viviansuzano/master-board/hardware/V3/master_board_labrob.brd

## EAGLE design hardware/V3/master_board_labrob.brd (2022-05-29)

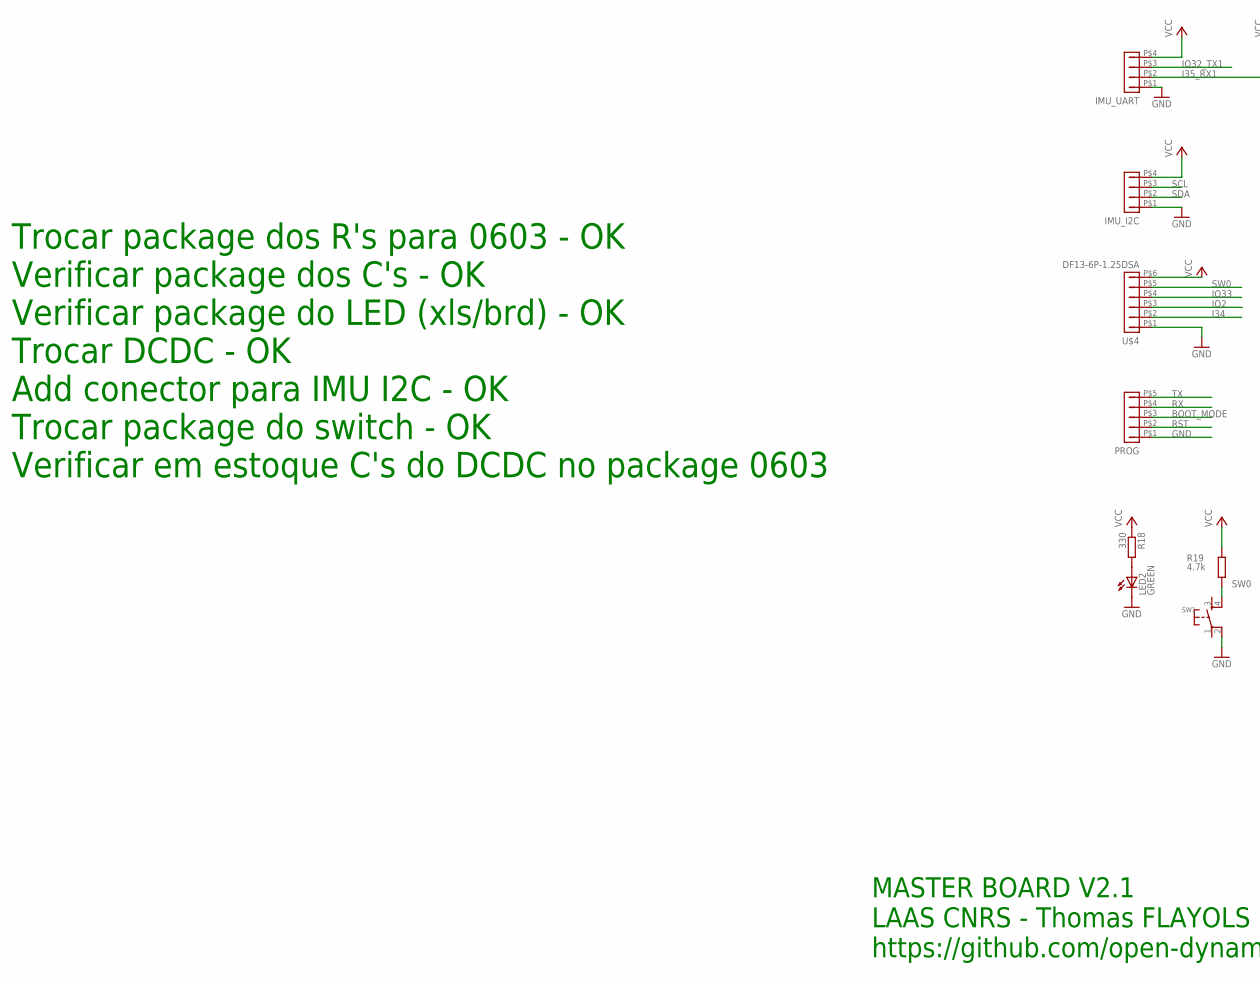
[picture p1: schematic master_board_labrob.sch, part in row 1, column 1]

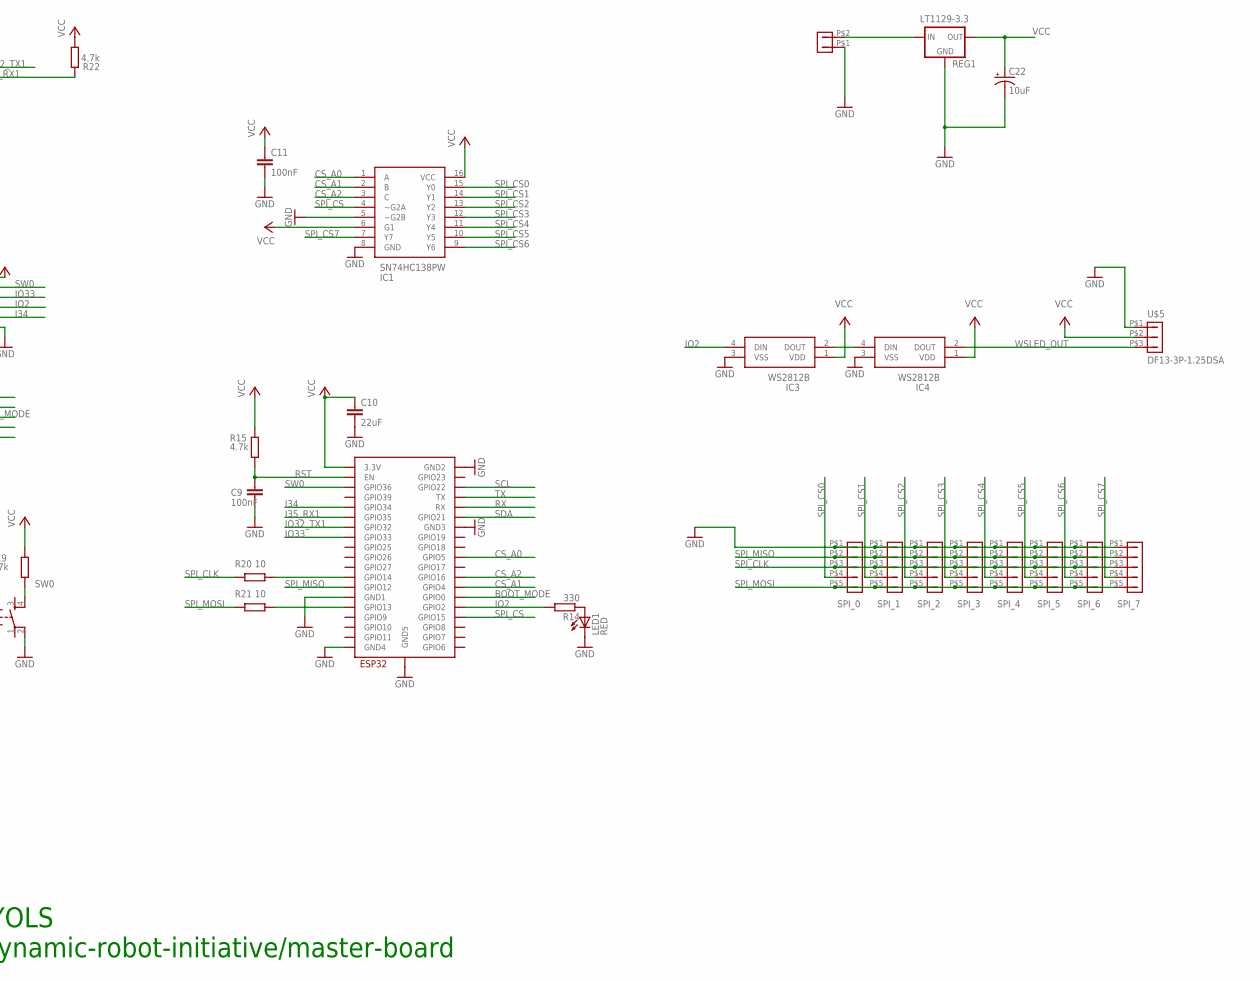
[picture p2: schematic master_board_labrob.sch, part in row 1, column 2]

Parts:
C9, C11: 100nF; C0603; MANUFACTURER_PART_NUMBER CPL-CAP-X7R-0402-100NF-16V
C10: 22uF; C0805; MANUFACTURER_PART_NUMBER CPL-CAP-X5R-0805-22UF-6.3V
C22: 10uF; C/6032-28R
IC1: SN74HC138PW; SOP65P640X120-16N
IC3, IC4: WS2812B
IMU_I2C: DF13-4P-1.25DSA; MANUFACTURER_PART_NUMBER DF13-4P-1.25DSA
IMU_UART: DF13-4P-1.25DSA; MANUFACTURER_PART_NUMBER DF13-4P-1.25DSA
LED1: RED; CHIPLED_0603; MANUFACTURER_PART_NUMBER CPL-LED-0603-RED
LED2: GREEN; CHIPLED_0603; MANUFACTURER_PART_NUMBER CPL-LED-0603-GREEN
POWER: DF13-2P-1.25DSA; MANUFACTURER_PART_NUMBER DF13-3P-1.25DSA
PROG: DF13-5P-1.25DSA; MANUFACTURER_PART_NUMBER DF13-5P-1.25DSA
R14, R18: 330; R0603; MANUFACTURER_PART_NUMBER RC0402JR-13330RL
R15, R19, R22: 4.7k; R0603; MANUFACTURER_PART_NUMBER CPL-RES-0402-4.7K-0.063W
R20, R21: 10; R0603; MANUFACTURER_PART_NUMBER CPL-RES-0402-10-0.063W
REG1: LT1129-3.3; SOT223
SPI_0, SPI_1, SPI_2, SPI_3, SPI_4, SPI_5, SPI_6, SPI_7: DF13-5P-1.25DSA; MANUFACTURER_PART_NUMBER DF13-5P-1.25DSA
SW1: B3U-1000P-2P-SMD; DTSM-6; MANUFACTURER_PART_NUMBER B3U-1000P
U$1: ESP32-WROOM; MANUFACTURER_PART_NUMBER ESP32-WROOM-32D
U$4: DF13-6P-1.25DSA; MANUFACTURER_PART_NUMBER DF13-6P-1.25DSA
U$5: DF13-3P-1.25DSA; MANUFACTURER_PART_NUMBER DF13-3P-1.25DSA

Connections:
BOOT_MODE: PROG.P$3 (3), U$1.IO0 (GPIO0)
CS_A0: IC1.1 (A), U$1.IO5 (GPIO5)
CS_A1: IC1.2 (B), U$1.IO4 (GPIO4)
CS_A2: IC1.3 (C), U$1.IO16 (GPIO16)
GND: C9.2, C10.2, C11.2, C22.-, IC1.5 (~G2B), IC1.8 (GND), IC3.3 (VSS), IC4.3 (VSS), IMU_I2C.P$1 (1), IMU_UART.P$1 (1), LED1.C, LED2.C, POWER.P$1 (1), PROG.P$1 (1), REG1.2 (GND), REG1.TAB (GND), SPI_0.P$1 (1), SPI_1.P$1 (1), SPI_2.P$1 (1), SPI_3.P$1 (1), SPI_4.P$1 (1), SPI_5.P$1 (1), SPI_6.P$1 (1), SPI_7.P$1 (1), SW1.2, U$1.GND1, U$1.GND2, U$1.GND3, U$1.GND4, U$1.GND5, U$4.P$1 (1), U$5.P$1 (1)
I34: U$1.IO34 (GPIO34), U$4.P$2 (2)
I35_RX1: IMU_UART.P$2 (2), R22.2, U$1.IO35 (GPIO35)
IO2: IC3.4 (DIN), R14.2, U$1.IO2 (GPIO2), U$4.P$3 (3)
IO32_TX1: IMU_UART.P$3 (3), U$1.IO32 (GPIO32)
IO33: U$1.IO33 (GPIO33), U$4.P$4 (4)
unnamed: IC3.2 (DOUT), IC4.4 (DIN)
unnamed: POWER.P$2 (2), REG1.1 (IN)
unnamed: LED1.A, R14.1
unnamed: R21.2, U$1.IO13 (GPIO13)
unnamed: LED2.A, R18.2
unnamed: R20.2, U$1.IO14 (GPIO14)
RST: C9.1, PROG.P$2 (2), R15.1, U$1.EN
RX: PROG.P$4 (4), U$1.RX
SCL: IMU_I2C.P$3 (3), U$1.IO22 (GPIO22)
SDA: IMU_I2C.P$2 (2), U$1.IO21 (GPIO21)
SPI_CLK: R20.1, SPI_0.P$3 (3), SPI_1.P$3 (3), SPI_2.P$3 (3), SPI_3.P$3 (3), SPI_4.P$3 (3), SPI_5.P$3 (3), SPI_6.P$3 (3), SPI_7.P$3 (3)
SPI_CS: IC1.4 (~G2A), U$1.IO15 (GPIO15)
SPI_CS0: IC1.15 (Y0), SPI_0.P$4 (4)
SPI_CS1: IC1.14 (Y1), SPI_1.P$4 (4)
SPI_CS2: IC1.13 (Y2), SPI_2.P$4 (4)
SPI_CS3: IC1.12 (Y3), SPI_3.P$4 (4)
SPI_CS4: IC1.11 (Y4), SPI_4.P$4 (4)
SPI_CS5: IC1.10 (Y5), SPI_5.P$4 (4)
SPI_CS6: IC1.9 (Y6), SPI_6.P$4 (4)
SPI_CS7: IC1.7 (Y7), SPI_7.P$4 (4)
SPI_MISO: SPI_0.P$2 (2), SPI_1.P$2 (2), SPI_2.P$2 (2), SPI_3.P$2 (2), SPI_4.P$2 (2), SPI_5.P$2 (2), SPI_6.P$2 (2), SPI_7.P$2 (2), U$1.IO12 (GPIO12)
SPI_MOSI: R21.1, SPI_0.P$5 (5), SPI_1.P$5 (5), SPI_2.P$5 (5), SPI_3.P$5 (5), SPI_4.P$5 (5), SPI_5.P$5 (5), SPI_6.P$5 (5), SPI_7.P$5 (5)
SW0: R19.1, SW1.4, U$1.SENSOR_VP (GPIO36), U$4.P$5 (5)
TX: PROG.P$5 (5), U$1.TX
VCC: C10.1, C11.1, C22.+, IC1.6 (G1), IC1.16 (VCC), IC3.1 (VDD), IC4.1 (VDD), IMU_I2C.P$4 (4), IMU_UART.P$4 (4), R15.2, R18.1, R19.2, R22.1, REG1.3 (OUT), U$1.3V3 (3.3V), U$4.P$6 (6), U$5.P$2 (2)
WSLED_OUT: IC4.2 (DOUT), U$5.P$3 (3)

Notes on the sheet:
MASTER BOARD V2.1 LAAS CNRS - Thomas FLAYOLS https://github.com/open-dynamic-robot-initiative/master-board
Trocar package dos R's para 0603 - OK Verificar package dos C's - OK Verificar package do LED (xls/brd) - OK Trocar DCDC - OK Add conector para IMU I2C - OK Trocar package do switch - OK Verificar em estoque C's do DCDC no package 0603

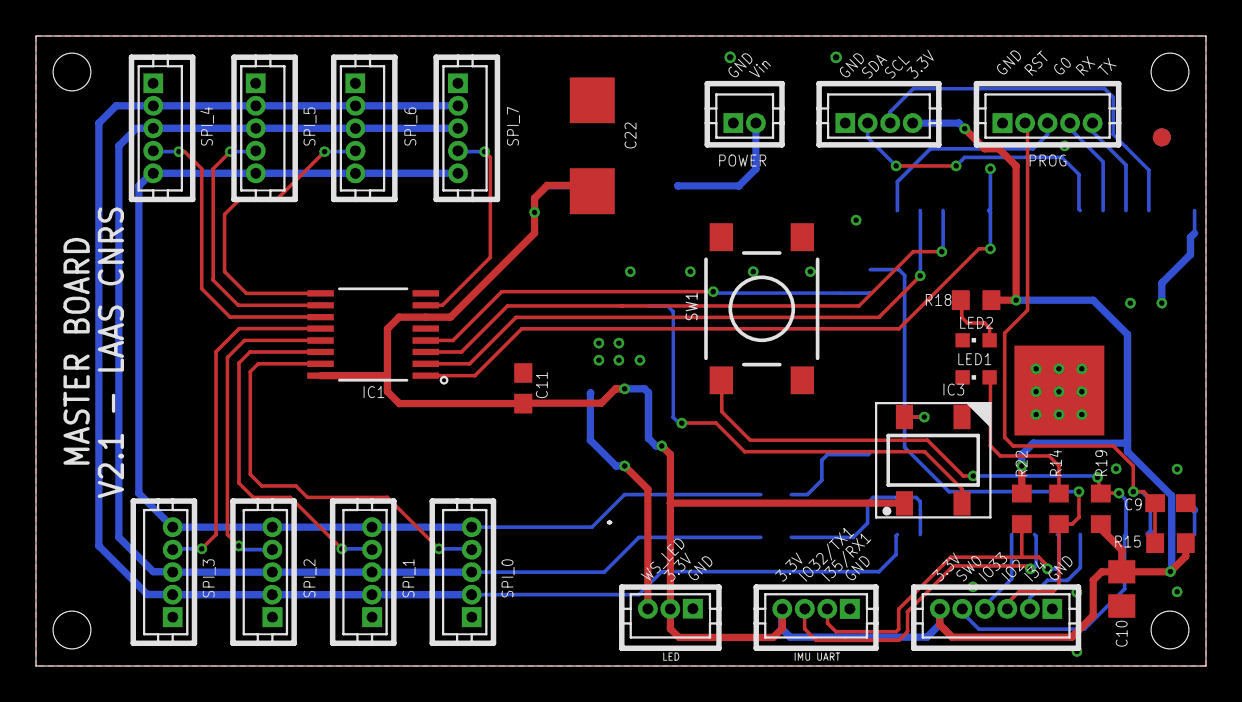
[picture p3: board master_board_labrob.brd from above]

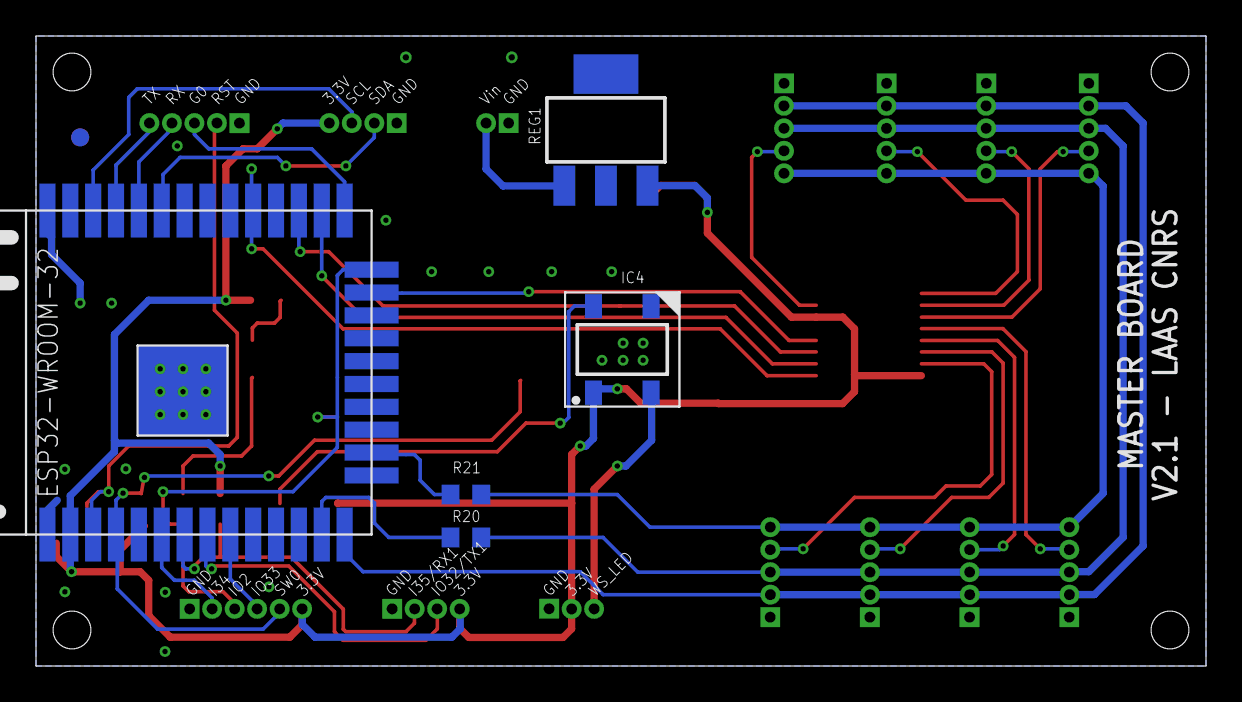
[picture p4: board master_board_labrob.brd from below]

Board: 2 copper layers, 65.0 x 35.0 mm, 35 parts (6 on the bottom side), 36 nets.

Other parts of the board:
REF2, REF4: VISION_REF10
