viviansuzano/master-board/(commit log)

2022-05-29 New customized version of the MasterBoard without ethernet communication option.
    [master_board_labrob.brd, master_board_labrob.sch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]
2022-06-05 Adds a file with instructions for flashing and testing the master-board. Adds an alternative firmware for testing spi communication only.
    [esp32_master_board.ods, esp32_master_board.xls]
2022-06-05 Add some debug prints do the sdk functions and updates the mac addresses.
