viviansuzano/master-board/(notices)

Notices in the files:
parts and their libraries:
dicons: Copyright (C) 2004, Bob Starr (rtzaudio@mindspring.com)
